hex-aragon/air-band/air-band/web/public/samples/README.txt

드럼 샘플을 쓰려면 이 폴더에 snare.wav, kick.wav, hihat.wav, tom.wav 를 넣으세요.
없는 파일은 앱이 Web Audio로 해당 드럼 소리를 합성해서 사용합니다.
