hex-aragon/air-band/air-band/docs/hackathon-plan.md

# Air Band 해커톤 플랜 · 작업 인계 문서

> 이 문서 하나로 다음 세션이 이어서 작업한다. 루트 `CLAUDE.md`가 이 파일을 자동으로 불러온다.
> 작성 2026-10-08 · 갱신 2026-10-09. 작업을 마칠 때마다 **7장 "진행 기록"과 3장 체크박스를 갱신**할 것.

---

## ⚠️ 2026-10-11 방향 전환 (이 장이 아래 내용보다 우선)

- **해커톤 제출 포기.** 1~3장의 해커톤 일정 · 제출물 · $BEAT 토큰 계획은 보류 (기록으로만 남김)
- **토큰 발행 안 함** (꼭 필요하다는 근거가 생기기 전까지). 위변조 방지는 기기 서명 · 어테스테이션 · DID 수준으로 검토
- 특허는 나중에 검토. 저장소는 2026-09-30부터 공개 상태임 (4장 검증 상태 참고)
- **다음 개발:** ① TinyML 노이즈 클래스 (2026-10-11 완료 · 배포) ② 폰 단독 모드 (2026-10-11 완료 · 배포, 실제 폰 미검증) ③ 지휘봉 모드 (2026-10-11 1차 완료 · 배포, 실기 미검증)
- 사용자 기획 문서(2026-10-11 "에어 밴드 프로젝트 — 전체 정리 / 할 일")가 기준. 경쟁 제품 대비 차별화를 계속 따질 것

---

## 0. 한 줄 요약

**누구나 그냥 치고 노는 에어 드럼.** 원하는 사람만 지갑을 연결하면, 진짜 스틱으로 친 점수가 보드 서명으로 증명되어
솔라나 리더보드에 오르고 보상을 받는다. AI 코치는 x402로 결제하는 유료 레슨을 준다. (하드웨어 + 솔라나 + AI 에이전트)

---

## 1. 대상 해커톤: Colosseum Crypto World's Fair (Solana 트랙)

- **마감: 2026-10-12 11:59pm PT = 한국 10/13(화) 오후 3:59.** 시각은 공식 규정을 인용한 제3자 정리(GitHub 이슈) 기준 → 등록 후 공식 규정에서 다시 확인
- 기간 9/14 ~ 10/12, 온라인. 2026-10-09 기준 등록 열려 있음: https://colosseum.com/worldsfair
- 이전에 만든 코드도 낼 수 있으나 **밝혀야 하고, 9/14 이후 작업만 심사** (에어 밴드는 9/30부터 작업 → 대부분 해당)
- 상금: 대상 $30k, 상위 20팀 $15k씩, **Solana 트랙 $100k (10팀 × $10k)**, 우승팀은 Colosseum 액셀러레이터($250k) 검토
- 제출물: 피치 영상 2~3분 · 데모 영상 3분 이하 · 공개 GitHub · GTM(시장 진입) · 수요 검증 · 배포 계획 · 팀 소개 · 로고
- 심사(동일 비중): 기능·코드 품질 / 시장 규모 / 새로움 / UX(블록체인 연동 품질) / 오픈소스·조합성 / 사업 계획. "스타트업 대회"라 실행 속도 · 소통 · 트랙션도 봄
- 솔라나 재단이 미는 주제: **에이전트 결제(x402, x402 MCP 서버, Metaplex Agent Kit)**, 스테이블코인 결제, 토큰화, 프라이버시
- 국내 10월 솔라나 해커톤은 못 찾음 (Solana Summit Korea는 초대제 컨퍼런스)
- x402: HTTP 요청에 결제를 담아 AI 에이전트가 API 이용료를 내는 표준. 솔라나 USDC가 주 정산 수단. 2026-07 Linux Foundation이 x402 재단 출범(솔라나 재단 · Visa · Stripe 참여)

출처: colosseum.com/worldsfair · cryptobriefing.com/colosseum-crypto-worlds-fair-hackathon · github.com/DeveloperAlly/solana-hack/issues/1 · solana.com/x402/what-is-x402

---

## 2. 원칙 · 설계

### 2.1 블록체인은 "선택"

| | 일반 사용자 (지갑 없음) | 블록체인 사용자 (지갑 연결) |
|---|---|---|
| 자유 연주 · 드럼 키트 · 리듬 게임 · TinyML | ✅ 전부 그대로 | ✅ 전부 그대로 |
| 점수 · 최고 기록 | 브라우저에 저장 | 브라우저 + 온체인 리더보드 |
| 보드 서명 (Proof of Play) | 받아서 **브라우저에 보관** | 트랜잭션으로 제출 |
| 보상 ($BEAT) | — | 받기 (하루 상한) |
| AI 코치 | 무료 기본 피드백 (지금 결과 화면의 타이밍 분석 확장) | 유료 심화 레슨 (x402) |

- 지갑 버튼은 결과 화면과 헤더 구석에만. 첫 화면 · 게임 흐름에는 지갑 이야기 없음
- **나중에 연결해도 손해 없음:** 서명된 기록을 브라우저에 쌓아 두고, 지갑 연결 시 이번 시즌 기록 일괄 제출
- 블록체인 코드는 `web/src/chain/`에 분리, **지갑 연결 시에만 동적 import** → 일반 사용자는 솔라나 라이브러리를 내려받지 않음
- **devnet 전용.** 토큰 판매 · 상장 · 수익 약속 금지 (국내 법 이슈). 발표에서는 "게임 보상 포인트"로 설명

### 2.2 전체 구조

```
[NU40 스틱 (오른손)] ── BLE (NUS) ──▶ [웹 (gh-pages)]
                                       게임 → 결과 요약 → 보드에 서명 요청 → 서명된 결과를 브라우저에 보관
                                       │ (지갑 연결한 사람만)
                                       ├──▶ [솔라나 프로그램 (Anchor, devnet)]
                                       │      register_device · submit_score(Ed25519 검증) · claim_reward
                                       │      PDA: Device · Season · Leaderboard · Player
                                       └──▶ [AI 코치 API (x402)]  402 → 지갑 결제 → 레슨 (Claude)
```

### 2.3 Proof of Play 흐름

1. 곡이 끝나면 웹이 결과 요약 생성: `곡 id · 점수 · 판정 개수 · 타격 기록 해시 · 보드 시각 범위 · 지갑 주소(있으면) · 시즌 nonce`
2. 웹 → 보드: 요약 해시를 BLE 명령으로 전송 (새 명령 `s` + 32바이트)
3. 보드: 게임 중 자기가 보낸 타격 패킷 누적 해시와 대조 → 맞으면 **보드 개인키(Ed25519)로 서명** 반환
4. 지갑 사용자는 `[Ed25519 검증 명령, submit_score]`를 한 트랜잭션으로 전송. 프로그램은 instructions sysvar로 "등록된 보드 공개키가 이 요약에 서명했는지" 확인
5. 키보드 · 터치 기록은 서명이 없으므로 로컬 기록만 (온체인 X)
- 펌웨어 빌드에 이미 `Adafruit_nRFCrypto`가 링크됨. 서명 구현은 먼저 Monocypher(소프트웨어 Ed25519)로

### 2.4 토큰 흐름 ($BEAT, devnet)

| 들어오는 곳 | 나가는 곳 |
|---|---|
| 인증된 플레이 보상 (하루 상한) | 곡 · 악보 팩 → 수익이 악보 제작자에게 |
| 시즌 순위 상금 | 토너먼트 참가비 → 상금 풀 |
| 내 악보가 플레이될 때 로열티 | AI 코치 심화 레슨 (USDC 또는 $BEAT) |

- 보상은 시즌 풀 안에서만, 기기당 · 지갑당 하루 상한. 해커톤 범위는 "인증 보상 + 리더보드 + 코치 결제"까지

### 2.5 에이전트 결제 아이디어
- **AI 코치:** 연주 기록(빠름/늦음 ms, 방향 오판, 드럼별 정확도) → 레슨 · 연습 곡. 1회당 x402 소액 결제
- **에이전트 간 결제 (로드맵):** 코치 에이전트가 맞춤 악보를 "악보 제작자 에이전트"에게서 x402로 구매 → 대금이 제작자 지갑으로

---

## 3. 일정 · 체크리스트 (4일 압축)

| 날짜 (KST) | 할 일 | 누가 |
|---|---|---|
| 10/9 (금) | Colosseum 등록 · 팀 등록 / 실제 스틱 스윙 테스트 / 웹 지갑 연결(선택형) + devnet Anchor 프로그램(점수 · 리더보드) | 사람: 등록 · 테스트, Claude: 코드 |
| 10/10 (토) | 보드 서명(Ed25519) 펌웨어 + 프로그램 검증 / 리더보드 화면 / $BEAT 보상 | Claude: 코드, 사람: 보드 업로드 · 확인 |
| 10/11 (일) | x402 AI 코치 API (호스팅 계정 필요) / 결과 화면 "레슨 받기" / 전체 흐름 리허설 | Claude: 코드, 사람: 호스팅 · API 키 |
| 10/12 (월) | 피치 · 데모 영상 촬영 / README · GTM · 수요 검증 문서 / 버그 수정 | 사람: 촬영, Claude: 문서 · 수정 |
| 10/13 (화) 오후 3:59 전 | 최종 제출 (여유 두고 오전에) | 사람 |

**뺄 것:** 두 번째 보드(킥은 보드 버튼 2), 악보 마켓 · 악보 에이전트, 토너먼트, TinyML 실기 학습 → 발표에서 로드맵으로.
**막히면 줄이는 순서:** ① 보드 서명이 늦으면 → 웹에 보드 공개키만 표시, 서명은 데모 영상에서 펌웨어 로그로 ② x402가 늦으면 → devnet USDC 단순 송금 + 응답으로 대체.

### 사람이 할 일 (Claude가 대신 못 함)
- [ ] https://colosseum.com/worldsfair 등록, 공식 규정에서 마감 시각 확인
- [ ] Phantom 지갑 설치 → devnet 전환 → devnet SOL 받기
- [ ] AI 코치 호스팅 계정 (Vercel 또는 Cloudflare Workers) · Anthropic API 키 (10/11 전)
- [ ] **GitHub 공개 여부 결정** — 소스가 아직 원격에 없음. 제출에는 공개 저장소 필요 (`hex-aragon/air-band`)
- [ ] 실제 스틱 고정 · 스윙 테스트 (5장 참고)
- [ ] 영상 촬영 · 최종 제출
- [ ] (보류) 저장소 `hex-aragon/air-band` 비공개 전환 — `gh auth login` 필요. 무료 계정이면 gh-pages가 꺼질 수 있음 → 진행 전 다시 확인

### 코드 작업 (Claude)
**1단계 — 기반**
- [ ] 리듬 게임 결과 요약 구조(`GameSummary`)와 해시 정의 (웹 · 펌웨어 · 프로그램 공통 바이트 순서 문서화)
- [ ] 실제 스윙 데이터로 판정 보정값 · 구역 확인 (사람 테스트 결과 반영)
- [ ] (선택) 웹 보드 2대 동시 연결 — 이번엔 뺌

**2단계 — 보드 서명**
- [ ] 펌웨어: 첫 부팅 때 Ed25519 키 생성 → 내부 플래시 저장. `?` 상태 · BLE로 공개키 확인
- [ ] 펌웨어: 게임 중 보낸 타격 패킷 누적 해시 (SHA-256)
- [ ] 펌웨어: `s` 명령 → 서명 반환 (BLE 응답 패킷 형식 추가)
- [ ] 웹: 결과 화면 "✓ 스틱 인증됨" 배지, 서명된 결과 localStorage 보관

**3단계 — 솔라나 프로그램**
- [ ] Anchor 프로그램 (devnet): `register_device`(관리자만) · `submit_score`(Ed25519 검증, nonce 재사용 거부, 최고 점수 갱신) · `claim_reward`(하루 상한)
- [ ] $BEAT mint (devnet) · 보상 풀 PDA
- [ ] 웹 `chain/` 모듈: Phantom 연결(동적 import) · 제출 · 리더보드 읽기 · 보관 기록 일괄 제출
- [ ] 리더보드 화면

**4단계 — 에이전트 결제**
- [ ] AI 코치 API (서버리스) + x402 (`402 Payment Required` → 지갑 결제 → 레슨)
- [ ] 결과 화면 "레슨 받기" 버튼 (지갑 없으면 무료 기본 피드백)

**5단계 — 제출**
- [ ] 데모 시나리오 리허설, 실패 대비 녹화
- [ ] README · 슬라이드(`docs/slides.html` 재사용) · GTM · 수요 검증
- [ ] 스틱 2개 이상 · 예비 배터리 · 예비 보드 · devnet RPC 2개

### 데모 시나리오 (3분)
1. **누구나:** 지갑 없이 리듬 게임 한 곡 — 드럼 키트 화면에서 링 맞추기 (30초)
2. **증명:** 결과 화면 "✓ 스틱 인증됨". 키보드로 친 점수엔 배지 없음 비교 (30초)
3. **선택해서 연결:** 지갑 연결 → 기록 제출 → devnet 리더보드 → $BEAT 받기 (45초)
4. **에이전트 결제:** "레슨 받기" → x402 결제 → AI 코치 레슨 ("하이햇을 늦게 친다, 20° 더 왼쪽") (45초)
5. **로드맵:** TinyML 개인 모델 · 악보 마켓 · 지휘 모드 · 양손/밴드 (30초)

### 위험 · 대응
| 위험 | 대응 |
|---|---|
| 실제 스윙에서 구역 · 판정이 어긋남 (아직 실기 검증 안 함) | 10/9에 실기 테스트 먼저. 판정 보정값 · TinyML |
| 보드 키 탈취 → 가짜 서명 | 해커톤은 관리자 등록 기기만. 실서비스는 CryptoCell 보안 키 · 기기 증명 |
| 다른 사람 기록 재제출 | 요약에 지갑 주소 · 시즌 nonce 포함, 사용한 nonce 거부 |
| 행사 · devnet 불안정 | 서명 기록 로컬 보관 후 제출, RPC 2개, 녹화 영상 |
| 토큰 법 이슈 | devnet 전용, 판매 · 상장 언급 없음 |

---

## 4. 지금까지 만든 것 (2026-10-09 기준)

### 배포 (gh-pages, https://hex-aragon.github.io/air-band/)
| 페이지 | 내용 | 상태 |
|---|---|---|
| `/` (index.html) | 자유 연주: 패드 · 스틱 방향 패널 · 녹음(재생 · MIDI · 공유 링크) · 지연 표시 | 배포됨 |
| `/kit.html` | **드럼 키트 화면**: 실제 드럼 세트 그림, 스틱이 모션 패킷을 따라 겨눔, 타격 효과, 마우스 · 터치로도 침 (펌웨어와 같은 구역 규칙) | 배포됨 |
| `/rhythm.html` | **리듬 게임**: 기본 화면 = 드럼 키트 위로 링이 좁혀 들어옴(osu 방식). "줄" 화면 선택 가능(하이햇←·스네어·탐→·크래시↑, 킥 가로 막대). 스틱 준비 체크리스트, 겨눈 곳 표시, 방향 힌트("← 더 왼쪽"), 센서 타격은 보드 시각 + 최소 지연으로 판정(지터 제거), 곡 3개(크래시 추가) | 배포됨 |
| `/tinyml.html` | **TinyML**: ① 개념 ② 데이터(드럼별 20번 수집, 가상 데이터, 산점도, CSV) ③ 학습(브라우저 MLP 12→16→4, 손실 곡선, 헷갈린 표, 실시간 시험) ④ `zone_model.h` 내보내기 | 배포됨 |

### 펌웨어 (`firmware/air_band_right/`)
- 2단계: IMU(LSM6DS @0x6A 가상 IMU · MPU6050 자동 감지) → Mahony 방향 추정(`orientation.h`) → 구역(정면 스네어 · 왼쪽 하이햇 · 오른쪽 탐 · 위 크래시, ±25°) → 피크 타격 감지 → BLE NUS 8바이트 패킷. 모션 패킷 0x80 25Hz. 명령 `c` 정면 · `m`/`x` 모션 · `?` 상태
- **TinyML 연동:** `USE_TINYML 1` + `zone_model.h`가 폴더에 있으면(`__has_include`) `classifyHit()`이 모델 사용, 없으면 규칙. `?` 상태에 `classifier=tinyml|rule`. 둘 다 컴파일 확인, 모델 +2.7KB 플래시. 25Hz 방향 기록 6개 링버퍼
- `DEBUG_RAW 1` → Edge Impulse data forwarder용 CSV(ax,ay,az,gx,gy,gz 100Hz)

### 검증 상태
- ✅ 웹 빌드 (`npm run build`) · 헤드리스 크롬 스크린샷으로 화면 · 마우스 입력 · 방향 힌트 · 학습 흐름 확인
- ✅ 펌웨어 컴파일 (모델 있음/없음)
- ❌ **실제 스틱 스윙으로 테스트한 적 없음** (구역 정확도, STICK_AXIS, 판정 지연, TinyML 실기)
- ⚠️ **원격 `hex-aragon/air-band`는 공개 저장소**(2026-09-30 생성). `main`에 9/30 커밋(d89ce32: 펌웨어 링버퍼 · 피크 트리거 · classifyHit 훅, 블로그 초안, 슬라이드)이 이미 푸시돼 공개 상태. 이후 작업은 로컬 `hackathon` 브랜치에만 있음 (7장). 특허 공지예외 기산일 판단에 필요 → 변리사에게 전달

### 주요 파일
```
air-band/
├ firmware/air_band_right/air_band_right.ino   펌웨어 (상수 · 분류 훅 classifyHit · TinyML)
├ firmware/air_band_right/orientation.h        방향 추정 · 구역 판정 (순수 계산)
├ web/index.html, src/main.ts                  자유 연주
├ web/kit.html, src/kit/{scene,main}.ts        드럼 키트 화면 (scene.ts는 리듬 게임도 사용)
├ web/rhythm.html, src/rhythm/{main,game,charts}.ts  리듬 게임
├ web/tinyml.html, src/tinyml/{model,main}.ts  TinyML (모델 학습 · C 헤더 내보내기)
├ web/src/{ble,audio,motion,recorder,visual}.ts 공통 모듈
└ docs/hackathon-plan.md                       이 문서
```

---

## 5. 하드웨어 메모

### 보드
- NUCODE NU40 DK: nRF52840, BLE 5.4, UF2 부트로더(리셋 두 번 → `BARAM-NU40` 드라이브). 버튼 4개(P0.11 · P0.12 · P0.24 · P0.25), I2C P0.26/P0.27. 실제 크기(mm)는 공개 자료에서 못 찾음 → 직접 재야 함
- 두 번째 보드 선택:

| 선택지 | 작업량 | 판단 |
|---|---|---|
| NU40 DK 1대 더 | 펌웨어 기기 이름 · hand 값만 변경 | ✅ 일정 짧으면 이것 |
| nRF54L15 DK를 킥(발)으로 | Arduino BSP 미지원 → Zephyr(nRF Connect SDK)로 타격 감지 + BLE만 새로 작성 | 54DK 꼭 쓰면 이것 |
| nRF54L15 DK를 왼손 스틱으로 | Zephyr 포팅 + 방향 계산 + 117×64mm 손목 장착 | ❌ 해커톤 범위 밖 |

- 패킷에 이미 hand 바이트(0 오른손 / 1 왼손) 있음. 웹은 지금 보드 1대만 연결

### 운영체제 (사용자가 "zapier"라고 부른 것 = Zephyr)
- NU40은 Zephyr 공식 보드: `nucode_nu40/nrf52840`, `west build -b nucode_nu40/nrf52840 samples/hello_world`, `zephyr.uf2`를 드래그
- **현재 펌웨어는 Zephyr가 아님:** Arduino BSP(NUBoards nRF52 by NUCODE, FQBN `nucode:nrf52:nu40dk`) 위의 FreeRTOS. 해커톤에는 옮기지 않음 (Thread/Matter · 제품화 때 검토)

### 스틱 고정 (사용자 안내 완료)
- 기본: 드럼스틱(5A) 손잡이 끝에 납작한 판(아크릴 · 합판) → 폼 양면테이프 2~3겹 + **케이블타이 2~3개 필수**(테이프만으로는 밀림) → 보드는 판 위에 테이프 + 케이블타이, IMU는 **+X 화살표가 스틱 끝** 방향, 전선은 절연테이프 · 글루건 고정, 손목 스트랩
- 보드가 크면: 보드 + 미니 보조배터리는 러닝 암밴드, 스틱엔 IMU만 (수축튜브), 실리콘 전선 26AWG 꼬아서 연결
- 확인: 세게 털어도 흔들림 없음 → 켤 때 1초 정지(자이로 보정) → 드럼 키트 화면에서 C 후 왼쪽으로 돌리면 하이햇이어야 함 (반대면 STICK_AXIS 수정)
- 사용자는 연결선은 이미 있음. 다이소: 판 · 폼테이프 · 케이블타이 · 절연테이프 · 글루건. 쿠팡: 5A 드럼스틱 · 3M VHB · 수축튜브 · GY-521(MPU6050, 0x68) 등

---

## 6. 이후 로드맵 · 아이디어 (해커톤 뒤)
- **지휘 모드 (검토 완료, 추천):** 박자 = 지휘봉 꺾이는 순간(자이로 pitch 회전 속도 부호 반전, **보드에서 감지** — 25Hz 모션으로는 40ms 단위라 부족), 셈여림 = 휘두르는 크기, 파트 지시 = 방향 구역. 템포를 따라가는 악보 재생기가 가장 큰 작업(녹음 파일 배속은 음높이가 바뀌므로 악보 예약 방식). 패킷 mode 바이트 1 = 지휘. 첫 곡: 브람스 헝가리 무곡 5번 또는 라데츠키 행진곡
- 악보 마켓 · 악보 에이전트 간 x402 결제 · 토너먼트
- 양손 · 킥 페달 센서 · 밴드 모드(기타 · 베이스)
- TinyML 실기 데이터 학습, Edge Impulse 원시 IMU 동작 인식(림샷 · 플램 · 세기)

---

## 7. 진행 기록 · 작업 방법

### 진행 기록 (최신이 위)
- **2026-10-16 (2)** 각도 오차 2차 개선 펌웨어 **보드 업로드 완료**(COM3, DFU는 COM4로 자동 전환). 가만히 둔 상태 `?`: sensorHz=417.3 · maxGapMs=2.9 · missed=0 · gyroSat=0 · still=yes · bias (2.55,-4.09,-0.81)°/s → 센서 값을 빠짐없이 읽음. **세게 친 뒤 좌우 오차 · gyroSat는 사용자 실기 확인 필요.** 저장소 비공개 전환은 사용자 요청으로 보류(3장 할 일에 남김)
- **2026-10-16** ① **각도 오차 2차 개선(펌웨어)**: LSM6DS는 STATUS_REG(0x1E) GDA 비트로 **센서 값마다(416Hz) 빠짐없이** 읽고, dt = 센서 값 간격(2초마다 실측해 맞춤) × 지나간 값 개수(읽는 시각 지터 무관), GDA가 안 켜지는 변종이면 10ms 타이머로 대체. 쿼터니언 적분을 1차 근사 → **정확한 회전(sin/cos)**. `?`에 `sensorHz · maxGapMs · missed` 추가. **가상 시뮬레이션**(scratch `sim/sim.cpp`, 실제 orientation.h를 zig c++로 빌드: 드럼 사이 이동 · 스트로크 꺾임 · 되튐 · 타격 진동 · 손목 비틀림 · bias · 잡음 · 배율 1% · ±2000 포화 · BLE 지연): 타격 200번 좌우 오차 평균 — 보통 세기 6.2°→**1.4°**, 세게 12.3°→4.7°(남은 건 자이로 한계 초과), ±4000°/s 센서면 1.7°. 컴파일 OK, **보드가 Windows에 안 보여(COM 없음) 업로드 못 함.** ② **내 연주 영상**(`src/trail/{trail,studio}.ts`): 리듬 게임 중 모션 25Hz · 타격 기록 → 결과 화면 "🎬 내 연주 영상" → 검은 바탕 네온 빛 궤적(Catmull-Rom, 작품 층 누적 + 0.7초 꼬리 + 타격 불꽃 · 드럼 색), 끝에 완성 그림 + 제목 · 점수 · 날짜. 세로 9:16 / 가로 16:9 / 정사각, 하이라이트 30초 / 전체. 영상 저장 = canvas.captureStream + MediaRecorder(MP4 지원 시 MP4, 아니면 WebM, 실시간), 드럼 소리 같이 녹음(유튜브 소리는 불가), PNG 저장. 스틱 없으면 드럼 자리 사이 가상 궤적. 헤드리스로 MP4 · PNG 저장 확인, 오류 0. 배포(ba907bd). ③ 저장소 비공개 전환: `gh auth login` 필요(아직 로그인 안 됨). ④ 두 번째 스틱 하드웨어 조언(NU40 DK 1대 더 + ±4000°/s IMU 권장, "50dk"는 모델 확인 필요)
- **2026-10-15 (3)** 사용자 실기: "칠수록 각도가 안 맞고 오차가 커짐". 원인 후보 1순위 = **방향 적분이 100Hz**(센서는 416Hz) → 타격의 짧은 꺾임(수십 ms, 1000°/s 이상)을 띄엄띄엄 재서 칠 때마다 좌우 오차가 쌓임(좌우는 중력 같은 기준이 없어 안 고쳐짐). 펌웨어: 읽기 · 방향 적분만 **400Hz**(`ORIENT_OVERSAMPLE 4`, 2.5ms), 타격 감지 · 링버퍼 · bias 정지 판정 · 모션 패킷은 그대로 100Hz, 블록 최대 가속도는 400Hz 전부에서. `?` 상태에 `gyroPeak · gyroSat(±1950°/s 넘은 샘플 수) · orientHz` 추가(읽으면 0으로). 시뮬레이션(타격 50번): 좌우 오차 평균 약 23° → 7.5°. 컴파일 OK, **보드 USB 미연결이라 업로드 · 실기 미확인.** 업로드 후 세게 친 뒤 `?`로 gyroSat 확인 — 0이 아니면 자이로 한계(±2000°/s) 초과라 다른 방법 필요
- **2026-10-15 (2)** 리듬 게임 판정 글자를 **화면 맨 위 가운데에 크게**(`#judge-big`, rhythm.html CSS 애니메이션): PERFECT! 금빛 그라데이션 · 빛 번쩍 · 튀어나옴, GREAT 하늘색, GOOD 초록, MISS 빨강 흔들림, 빠름/늦음 ms, 콤보 2 이상 표시(10콤보마다 금색). 드럼 옆 판정 글자는 작게만, 캔버스 콤보 숫자 제거. 폰 폭에선 점수줄 아래(top 64px). 배포(005bcef). 주의: `pkill -f "vite preview"`는 자기 셸까지 죽인다 → PID로 kill
- **2026-10-15** 사용자: "We Will Rock You가 원곡 멜로디가 아님 → 유튜브 노래로", "MP3 연동 말고 다 유튜브 링크로, UX 편하게". 리듬 게임을 **유튜브 전용**으로 개편: 탭 순서 ⭐ 인기곡(기본, We Will Rock You 선택) · 🔗 유튜브 링크로 · 🎯 연습곡(음악 없이). 인기곡 8곡에 공식 뮤직비디오 id(oEmbed로 공식 · 임베드 허용 확인) · 대략 BPM · 탭 안내(`charts.ts` POP_SONGS, WWRY는 "짝"마다). 흐름: ▶ 노래 틀기 → 화면 가운데 큰 영상 + 탭 화면(점 8개) → 8번 탭 → **영상을 멈추지 않고 그 자리에서 게임 시작**, 박자 저장 → 다음부터 ▶ 시작으로 처음부터. `fitKnownTaps`(대략 BPM으로 번호 매김, 혼자 튄 탭 · 두 번 친 탭 제외 — 늦은 탭 · 놓친 탭 · 박마다 탭 모두 시험 통과). `followDrift`: 맞힌 타격이 한쪽으로 밀리면 남은 노트를 ±40ms씩(총 ±600ms) 옮김. 링크는 붙여 넣으면 바로 추가, 제목은 플레이어에서. **MP3 · 파일 분석 UI 제거**(music.ts 분석 함수는 남겨 둠). 가짜 유튜브 플레이어로 PC · 폰 폭 전체 흐름 시험(정확도 95%, 다시 하기 · 링크 추가 확인). **실제 유튜브 재생 · 실제 곡 박자는 사용자 확인 필요.** 배포(60a2102)
- **2026-10-14 (3)** 지난 세션에서 반쯤 된 UI 개편 마무리: 공통 위 메뉴(`src/ui/header.ts` — 드럼 · 클래식 · 머신러닝 탭, "스틱 연결" 버튼 하나로 연결 · 축/정면 맞추기 안내 · **드럼 간격 좁게/보통/넓게** = 보드 명령 `1`/`2`/`3`), 3D 드럼 키트(`kit/kit3d.ts`, three.js, WebGL 안 되면 2D), 자유 연주 → `pads.html`(패드 · 녹음)로 이름 변경. 빠져 있던 **첫 화면 `index.html`**(기능 카드 5개, 예전 `#take=` 공유 링크는 pads.html로 넘김) 추가, vite 입력에 pads 추가, 리듬 게임 곡 카드 그림이 좁게 나오던 것 수정. 헤드리스 크롬으로 6페이지 PC · 모바일 오류 0 · 가로 넘침 없음 확인. 보드(COM3)는 이미 최신 펌웨어(`?` zoneDeg 40/35, `3`→55/45 전환 확인, still=yes). gh-pages 배포(17cb8bb). 두 번째 보드 없음 → 스틱 2개 작업 보류
- **2026-10-14 (2)** 사용자 실기: 드럼이 한곳에 모여 방향이 잘 안 맞음 → 구역 25° → **좌우 40° · 위 35°**(펌웨어 ZONE_* · web motion.ts ZONE_DEG · phone.ts), 드럼 키트 화면 배치도 넓힘(scene.ts SPOTS · VIEW). 노래 맞춰 치기 단순화: "노래 파일 고르기" 큰 버튼 → 준비 완료 → "이 노래로 시작", 유튜브(탭)는 접힌 칸으로. 사용자가 유튜브 뮤직으로 MP3 받기 물음 → 불가(오프라인 저장은 앱 안 잠김, 변환 사이트는 약관 위반) · MP3 구매 파일 권함. 스틱 2개는 두 번째 보드 있으면 진행(사용자 답 대기). 보드 업로드 · gh-pages 배포(fd6025a)
- **2026-10-14** 사용자: 축 · 정면 맞춰도 인식이 잘 안 됨. **실측 원인: 자이로 오차 추적이 영영 안 됨** — 부팅 보정 때 움직여서(흔들림 148°/s) bias가 (-14,-7.6,-2.7)°/s로 틀렸고, "정지" 판정이 bias를 뺀 값 < 3°/s라 틀린 bias로는 정지를 못 알아봐 고쳐지지 않음 → 가만히 둬도 좌우가 1.4°/s씩 흐름(18초에 25° = 구역 하나). `GyroBias`를 원본 자이로의 0.5초 흔들림(최대-최소 <10°/s)으로 정지 판정하도록 고침, 부팅 보정이 흔들렸으면 첫 정지 때 한 번에 교체, 30°/s 넘는 차이는 "천천히 도는 중"으로 무시. 업로드 후 1초 만에 실제 bias (2.52,-4.04,-0.78)로 맞고 30초 동안 좌우 0.0° 유지. `?` 상태에 `still · biasUpdates` 추가. 웹: 축 맞추기 3초 · 정면 맞추기 2초 **카운트다운**(`src/calib.ts`, kit · rhythm · conduct). **리듬 게임 "내 노래로 치기"**: ① 유튜브 링크(IFrame API 임베드 — 소리 다운로드는 저작권 · 약관 문제라 안 함, 예시 Dani California 공식 MV 임베드 가능 확인) + 박마다 탭 → `fitTaps` 직선 맞춤으로 BPM · 첫 박 → 난이도별 록 패턴, "중간에서 한 번 더" 탭을 합쳐 BPM 정밀도 ↑, 영상 재생 위치를 시계로 판정(`syncMediaClock`), 박자는 localStorage 저장 ② 음악 파일: 브라우저 안에서 대역 3개 onset → 자기상관 + 격자 맞춤 BPM, 박마다 ±50ms 추적, 킥/스네어로 마디 첫 박, 후렴 세기 상승에 크래시 · 앞 마디 탐 필인, 난이도 쉬움/보통/어려움(4·8·16분), 스틱 1개라 한 칸에 스틱 노트 하나. 시험: 합성 곡(100 · 137 BPM) BPM 정확 · 박 오차 평균 <1ms · 노트 97~100% 정답 위치, 정답 시각에 키 입력 98.1%; 가짜 유튜브 플레이어(50ms 단위 시각)로 탭 96.1→합쳐서 95.97 BPM(정답 96), 따라 치기 98.8%. **실제 유튜브 재생은 헤드리스에서 막혀 미확인, 실제 곡 파일 분석도 미확인.** gh-pages 배포(803233d), 사용자 실기 확인 대기
- **2026-10-12** 사용자: 박 인식이 너무 빡셈, 연결이 잘 안 됨. 보드 축은 이미 (1.00,-0.08,0.03)로 저장돼 있었음 → 원인은 기준값. **박 감지 2중화**(`ictus.h`/`ictus.ts` 동일): ① 위아래 바닥점(기준 25→12°/s, 4→2.5°) ② **툭 멈춤 가속도 봉우리**(중력 뺀 움직임 가속도 ≥0.22g, 센서 방향 무관, `StickOrientation::gravityBody()` 추가). 같은 박 중복은 220ms 간격으로 거름. 시뮬레이션: 3° 작은 동작 · 축 틀림 · 160BPM 모두 첫 박 외 전부 잡힘, 가만히 20초 0개. 폰도 `ev.acceleration` 사용. **BLE 자동 재연결**: 끊기면 같은 기기에 0.5~5초 간격 5번, 첫 연결 실패 시 3번 재시도, 오류 문구 한글화. 보드 업로드 · 배포
- **2026-10-12** 사용자: 누코드로 지휘하면 박이 하나도 인식 안 됨(보드 USB 미연결이라 실측 못 함). 원인 후보: ① 지휘 화면에 축 맞추기가 없어 STICK_AXIS 기본 +X(실제 장착과 다르면 위아래가 안 잡힘) ② 연습 모드는 시작 전 박 표시가 없었음. → 지휘 화면에 ① 축 맞추기(A) · ② 정면 맞추기, HUD에 위아래 각도 · 박 카운터, 시작 전에도 "박!" 표시, 2.5초 동안 좌우 30°↑ · 위아래 8°↓면 축 맞추기 안내. 폰 모드 가짜 센서로 확인 후 배포. **실기 재확인 필요**
- **2026-10-12** **지휘 재생목록 7곡** (곡 선택, 마지막 곡 기억): 환희의 송가 · 슈베르트 미완성(첼로 주제, 3/4, 낮은음자리표) · 라흐마니노프 협주곡 2번 1악장(2/2, 2박 지휘, 피아노 분산화음) · 브람스 1번 4악장(알프호른 → 큰 주제) · 백조의 호수 · 꽃의 왈츠(3/4 왈츠 반주) · 홀스트 목성(Thaxted, 못갖춘마디). 선율은 기억 대신 기계 판독 자료: **MTD**(AudioLabs Erlangen, 주제 페이지에 내장된 MIDI를 파싱 — 라이선스 표기 없음, 음 높이 · 길이만 사용) · **Mutopia #527**(Thaxted, PD, 코드 포함). `arrange.ts` 편곡기(코드 기호 → 현악 화음 · 베이스 · 호른 · 팀파니, 반주 pad/waltz/syncop/arpeggio), 주제가 끊기는 곡은 2~3마디 마무리 편곡(about에 표시). 악보: 조표 ± · 높은/낮은음자리표 · 임시표 · 2/2 음표 · 못갖춘마디 마디줄. 지휘 도형 2 · 3 · 4박, 방향 판정 3박(2박 오른쪽). 사운드폰트에 cello · piano · oboe 추가, 필요한 음 112개만(2.8MB). **리스트 사랑의 꿈은 보류**(MTD엔 첫 11음뿐, 화음 자료 없음; piano-midi.de 접속 차단). 차이콥스키 교향곡 · 협주곡 주제는 MTD에 없음. 헤드리스 크롬 7곡 재생 · 화면 확인, 배포
- **2026-10-11** 지휘 화면에 **따라하기 연습 모드**(기본) + **흐르는 악보**: 고정 템포(`FixedTempo`, 50~110 BPM) · 준비 박 4번 메트로놈 · 노란 공이 4박 도형(1↓ 2← 3→ 4↑)을 따라 움직임 · 박마다 정확/좋아요/빨라요/늦어요(±70/150ms) · 센서 있으면 2박 왼쪽 · 3박 오른쪽 방향 확인 · 끝나면 박 맞춤 %, 평균 오차, 빠름/늦음 경향. 음악 끄고 메트로놈만 가능. 악보: `score_view.ts` 캔버스 오선(높은음자리표 직접 그림, D장조 조표, 지금 음 노랑, 박 세기 1~4). 헤드리스 크롬으로 PC · 모바일(390px) 화면, 판정, 끝 점수, 실전 모드 회귀 확인 후 배포
- **2026-10-11** **지휘봉 모드 1차** (`web/conduct.html`, `src/conduct/{ictus,follower,player,score,main}.ts`, 펌웨어 `ictus.h`): 박(ictus) = 위아래 각도가 내려가다(<-25°/s) 위로 돌아서는 바닥점, 꼭대기→바닥 4° 이상. 보드 명령 `k` 지휘 / `d` 드럼 → 박 패킷 mode 1 (velocity = 크기 × 2). 폰도 같은 규칙. 템포 추종: 준비 박 2번 → 3번째 박에 시작, 박마다 다음 박에 닿도록 속도 보정, 2.2박 무응답이면 기다림. 셈여림 = 박 크기, 왼쪽 겨누기 = 현악 · 오른쪽 = 호른/팀파니 강조. 키보드 스페이스 · 화면 탭 = 박. 곡: **환희의 송가** 자체 편곡 (1절 현악 p, 2절 호른 · 팀파니 f, 33마디). 소리: FluidR3 GM(MIT, gleitz CC BY 3.0) 필요한 음만 `public/sf/` (2MB). 시험: 박 감지 합성 궤적 · 템포 추종(100→120→80 BPM, 멈춤 · 재개) node 시험, 헤드리스 크롬 스페이스 지휘, 보드 k/d 전환 확인. **실제 지휘봉 스윙 미검증.** 라데츠키는 IMSLP 스캔(#30496, PD) 해상도로는 주제 선율을 정확히 못 읽어 보류 → 깨끗한 악보 자료 필요
- **2026-10-11** 노이즈 펌웨어 보드 업로드 · gh-pages 배포. **폰 단독 모드** (`web/src/phone.ts`): deviceorientation으로 스틱 방향(기본 폰 윗변 +Y, 축 맞추기 지원), devicemotion |가속도| 피크(2.2g, 불응 150ms)로 타격 → 보드와 같은 HitEvent/MotionEvent. `AirBandConnection.connectPhone()`로 붙여 자유 연주 · 키트 · 리듬 게임에 "📱 폰으로 치기" 버튼. 헤드리스 크롬에서 가짜 센서 이벤트로 4방향 판정 확인, **실제 폰 미검증**, 배포함
- **2026-10-11** 방향 전환(해커톤 포기 · 토큰 보류). TinyML **노이즈 클래스**: 모델 입력 18개(25Hz × [좌우, 위아래, 40ms 최대 가속도]) · 출력 5개(노이즈=9), 노이즈 판정 시 펌웨어가 타격을 안 보냄. 모션 패킷 [6..7]을 40ms 블록 최대 가속도로 변경. 타격 LED는 `HIT_LED 0`(디버그용 옵션)으로 끔. 합성 데이터 시험 검증 88% · 노이즈 10/11, 모델 포함 펌웨어 컴파일 확인. **보드 업로드 · 배포 안 함**(업로드 중 USB 빠짐)
- **2026-10-09** 사용자 실기: "위치가 안 맞음". 원인 후보 1순위 = STICK_AXIS(+X 고정)와 실제 장착 방향 불일치 → 펌웨어 `a` 축 맞추기(스틱 세운 중력 방향 = 축, InternalFS 저장, 결과 패킷 0x81) + 웹 kit · rhythm "축 맞추기" 버튼. 보드 업로드(LSM6DS 정상, axis 기본 +X) · gh-pages 배포 완료, 사용자 실기 확인 대기
- **2026-10-09** 해커톤 조사(Crypto World's Fair 선정), 4일 일정, 이 인계 문서 · 루트 CLAUDE.md 작성, 로컬 백업 커밋(작업 브랜치 `hackathon`, 푸시 안 함)
- **2026-10-08** 드럼 키트 화면, 리듬 게임 스틱 UX + 드럼 키트 링 화면, TinyML 페이지 + 펌웨어 연동, 전부 gh-pages 배포. 하드웨어 고정 · 구매 안내, 지휘 모드 · Zephyr 검토
- **2026-10-07** 2단계(방향 구역) · 녹음 기능 배포

### 작업 방법
- **배포 (gh-pages):** `cd air-band/web && npm run build` → 스크래치 폴더에 `git clone --branch gh-pages --single-branch git@github.com:hex-aragon/air-band.git` → `.git` · `.nojekyll` 빼고 전부 지우고 `dist/*` 복사, `.nojekyll` 유지 → 커밋 · 푸시 → 1분쯤 뒤 `curl`로 새 asset 이름 확인
- **배포 · 커밋 · 푸시는 사용자에게 먼저 묻는다** (예외: 사용자가 그 작업을 직접 요청한 경우)
- **펌웨어 컴파일 (WSL):** `"/mnt/c/Users/Robert/AppData/Local/Programs/Arduino IDE/resources/app/lib/backend/resources/arduino-cli.exe" --config-file 'C:\Users\Robert\.arduinoIDE\arduino-cli.yaml' compile --fqbn nucode:nrf52:nu40dk air_band_right` (firmware 폴더에서). 업로드 포트 COM3, 부트로더에 걸리면 COM4
- **화면 확인:** `npx vite preview --port 4173` + Playwright 크로미움(`~/.cache/ms-playwright/chromium-1140`, 스크래치에 `npm i playwright-core@1.48.2` 후 `npx playwright-core install chromium`)으로 스크린샷
- 하드웨어 사실(핀 · 크기 · 주소)은 **추측하지 말고** 확인 필요로 남긴다 (루트 README의 원칙)
- 사용자와는 한국어로
