hex-aragon/air-band/air-band/docs/images/05-log.png

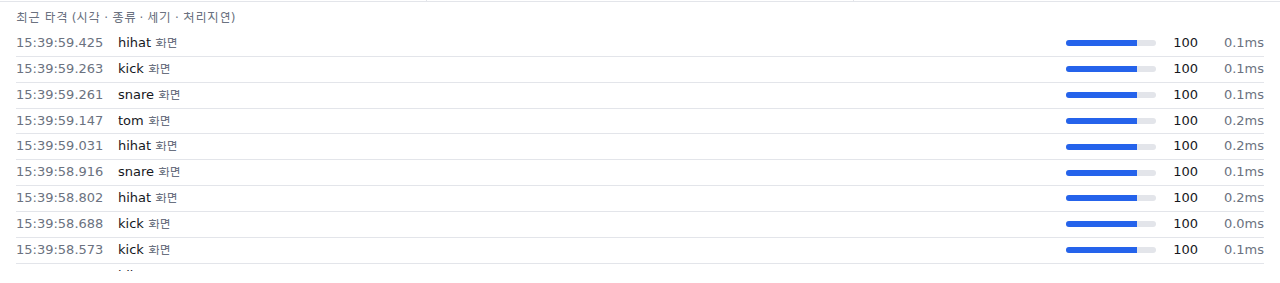
air-band/docs/images/05-log.png
