hex-aragon/air-band/air-band/docs/images/13-rhythm-mobile.png

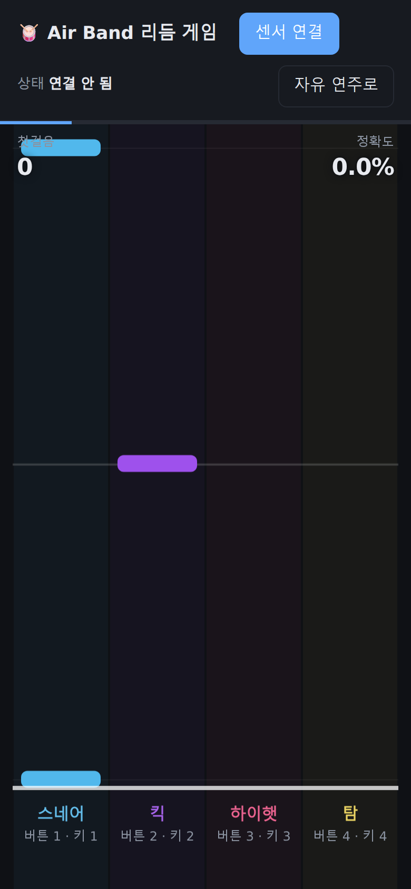
air-band/docs/images/13-rhythm-mobile.png
