hex-aragon/air-band/air-band/docs/images/12-rhythm-result.png

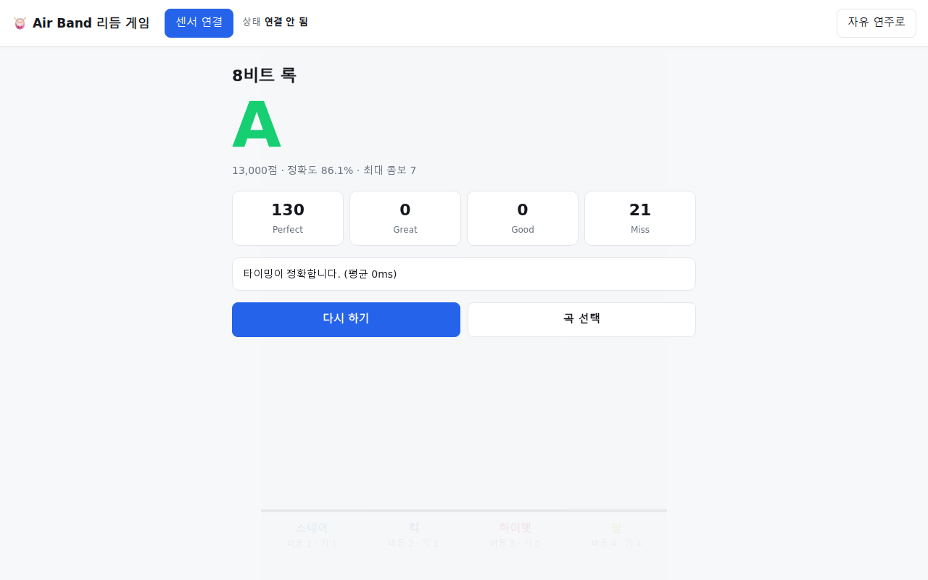
air-band/docs/images/12-rhythm-result.png
