hex-aragon/air-band/(commit log)

2026-10-15 Air Band: 지휘 모드, 3D 드럼 키트, 공통 메뉴, 유튜브 리듬 게임, 판정 효과
    - 펌웨어: 자이로 오차 추적 수정, 박(ictus) 감지, 드럼 간격 명령 1/2/3, TinyML 노이즈 클래스
    - 웹: 첫 화면 · 공통 위 메뉴(스틱 연결 · 맞추기 안내) · 3D 드럼 키트 · 패드 페이지 분리
    - 지휘하기: 7곡 재생목록, 따라하기 연습, 흐르는 악보, 사운드폰트
    - 리듬 게임: 인기곡 공식 유튜브 영상 + 탭 8번으로 박자 맞추고 바로 시작, 링크로 아무 노래, MP3 제거
    - 판정 글자 화면 맨 위 크게 (PERFECT 금빛 · MISS 흔들림 · 콤보)
    - 폰 단독 모드, BLE 자동 재연결
    Co-Authored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
2026-10-15 펌웨어: 방향 적분 400Hz로 (칠수록 좌우 각도가 틀어지던 문제), 자이로 포화 진단
2026-10-15 펌웨어 각도 오차 개선(센서 값마다 · 정확한 회전) + 내 연주 영상(빛 궤적 영상 · 그림 저장)
2026-10-26 인계 문서: 10/16 진행 기록 갱신
